SuperM22/GasSentinel/gasSentinel/Photos/map.png

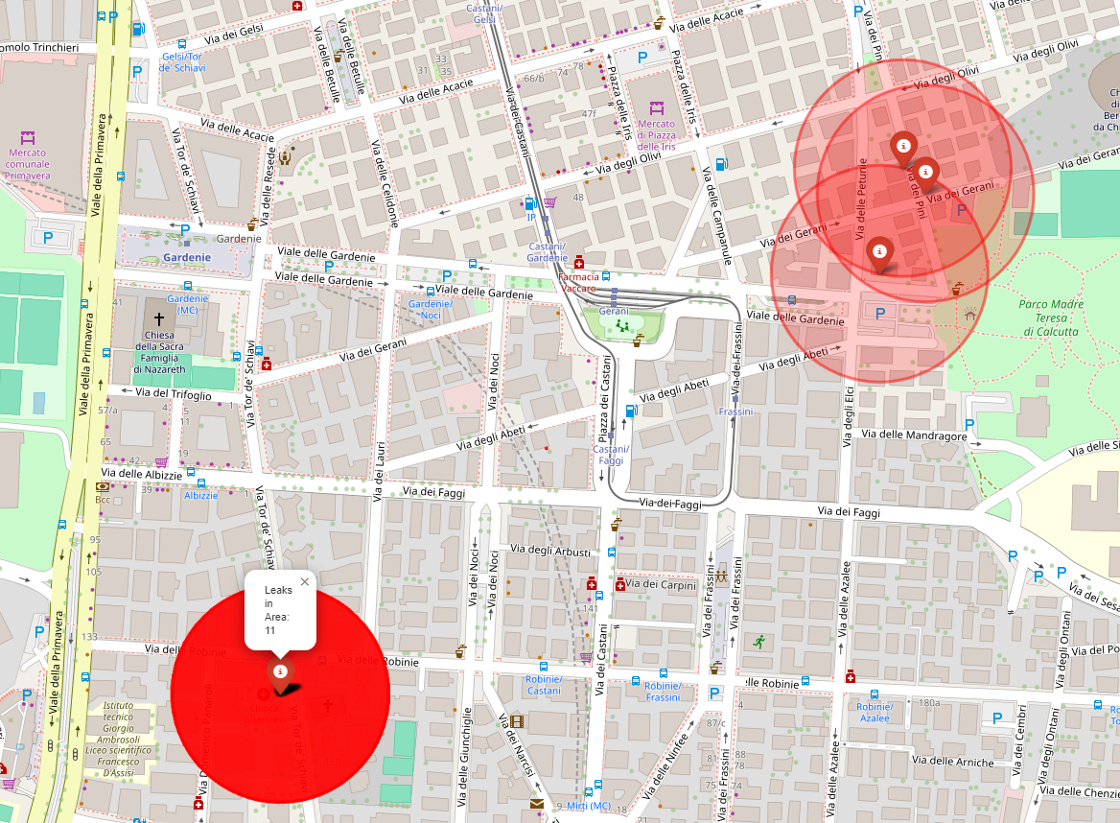
gasSentinel/Photos/map.png
