SuperM22/GasSentinel/gasSentinel/Photos/LoRA latency.png

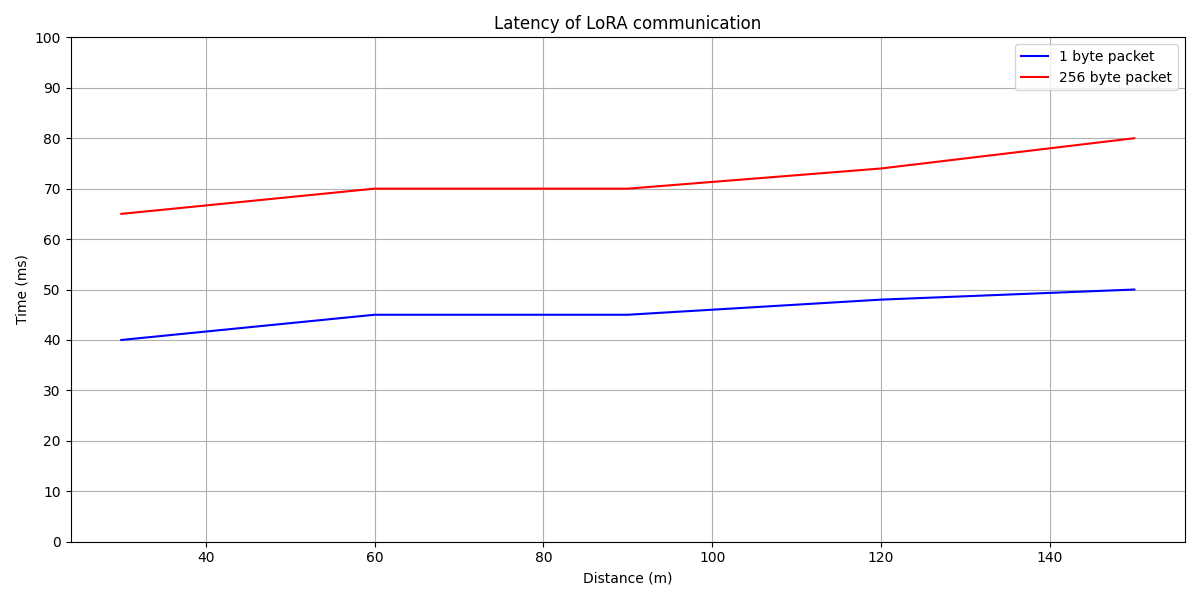
gasSentinel/Photos/LoRA latency.png
