SuperM22/GasSentinel/gasSentinel/Photos/menuconfig.png

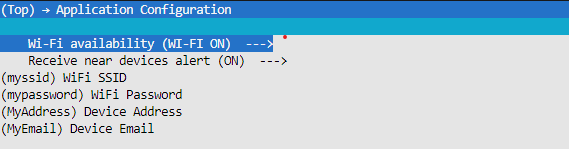
gasSentinel/Photos/menuconfig.png
