SuperM22/GasSentinel/gasSentinel/Photos/Current Usage Everything off.png

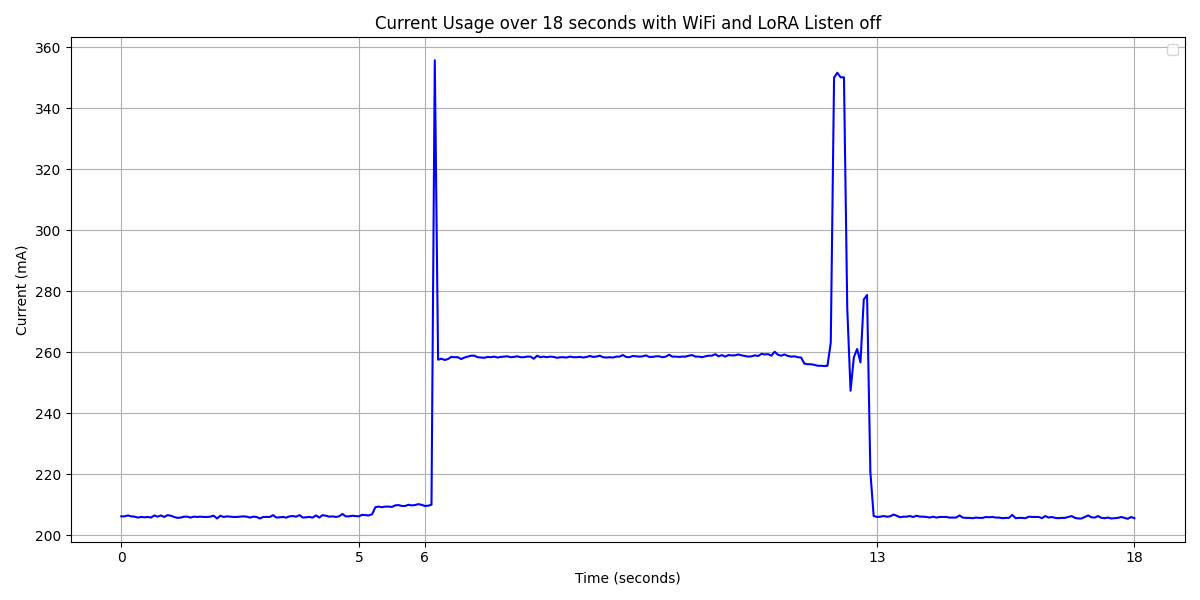
gasSentinel/Photos/Current Usage Everything off.png
