SuperM22/GasSentinel/gasSentinel/Photos/Current Usage everything on.png

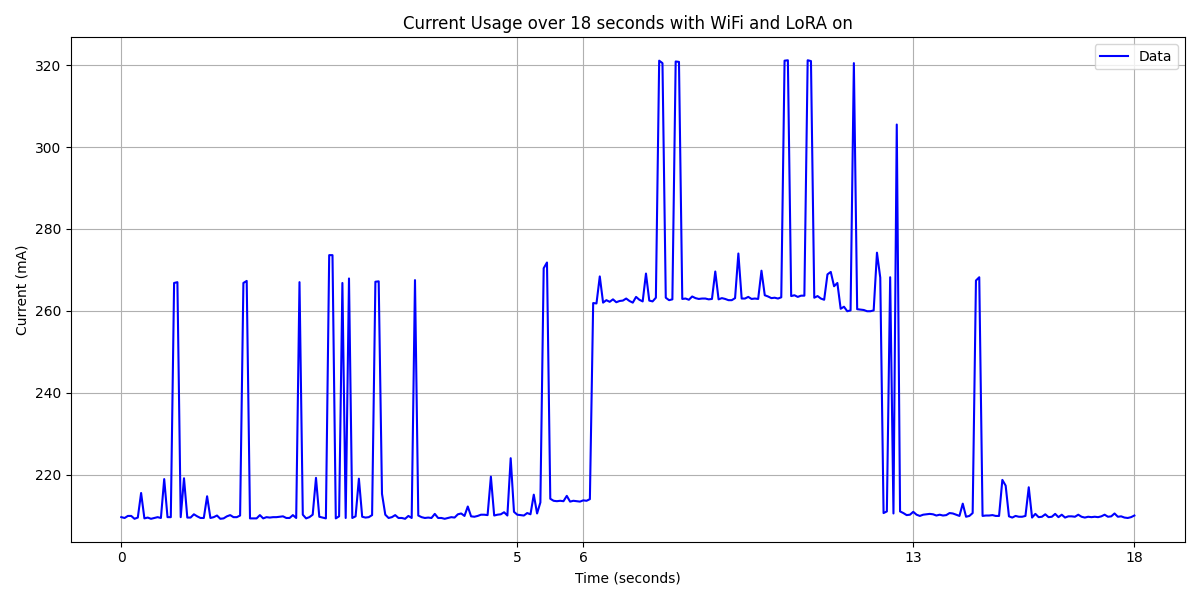
gasSentinel/Photos/Current Usage everything on.png
