SuperM22/GasSentinel/gasSentinel/Photos/LoRa Performance Packet Loss Rate vs. Distance with Obstacles.png

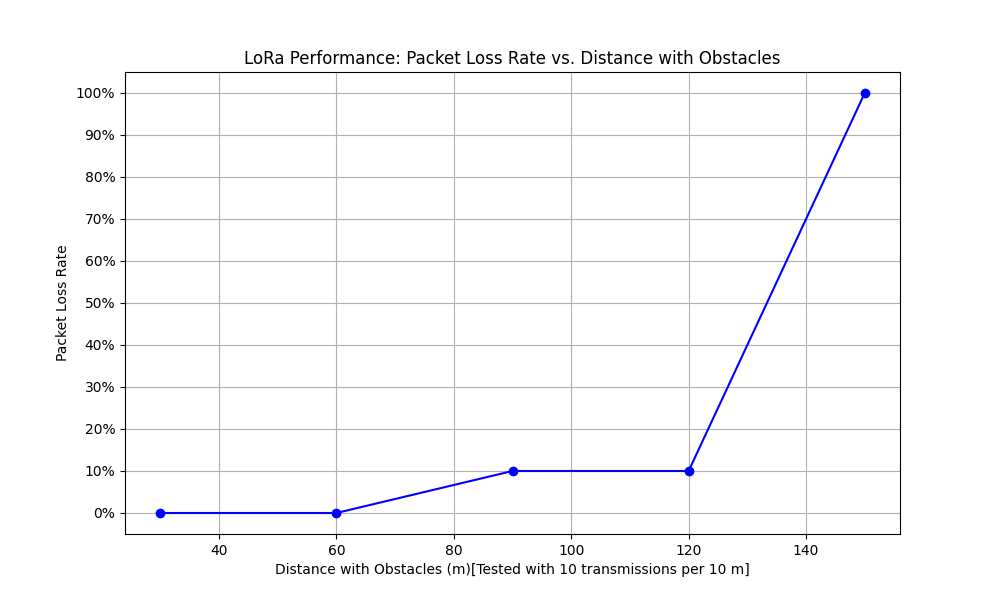
gasSentinel/Photos/LoRa Performance Packet Loss Rate vs. Distance with Obstacles.png
