SuperM22/GasSentinel/(commit log)

2024-05-28 code for Buzzer and LED
    [gasSentinel.c]
2024-05-30 Proper gas sensing + alarm
    Integration of the mq2 sensor + proper alarm sensor
2024-05-30 To alert the other users about the gas leak nearby added buzzer and led through esp-now
    [gasSentinel.c]
2024-06-19 MQ2 calibration
2024-06-20 get resistance r0
2024-06-25 Made the correction of not sending multiple emails within a time window. MQTT is now sending a json payload
    [gasSentinel.c]
2024-06-25 Perfectioning of the calibration process + ppm correct measurement
    [calib.ino, gasSentinel.c]
2024-07-03 Added support for device location
2024-07-04 fixed the memory error
    [gasSentinel.c, helper.c]
2024-07-04 NOWIFI mqtt message fix
    [gasSentinel.c]
2024-07-07 Fix no receive config
    [gasSentinel.c]
2024-07-09 removed timers
